Ikigai4Ever/RC_car_embedded_project/Documentation/ECE_4140_Project_Report.docx

Seek and Destroy RC Car

ECE–4140 Embedded Systems Project

Christopher Bowman (Masters)

Ty Ahrens

Blake Hudson (Masters)

Project Objective

Create an RC car that can autonomously find a package and be

manual controlled.

Overview

The Seek and Destroy RC car is a wireless RC car designed for Autonomous navigation and manual control. The RC car is composed of 3 different subsystems: Controller, Seeker, and Package. The Controller system controls the Seeker system which seeks the Package system. The Controller uses Multiple ADCs to control the movement of the Seeker module. Bluetooth modules using UART allow the Controller to send the ADC values wirelessly to the Seeker module. The Seeker module is equipped with 2 high RPM motors controlled with a PID using the motors encoder sensor for a closed loop feedback path. PID is fine-tuned which outputs corresponding PWM signals for the motors. The Seeker has custom 3d printed body and wheels. A Buck Converter is used to handle the 12V power supply for Motors and the Nucleo board. The Package module uses esp-32 signal strength to determine how far the Seeker is away from the Package. An Ultrasonic sensor is used to avoid obstacles while navigating towards the Package.

Detailed Design

Controller (Ty and Blake)

Seeker (Evan, Ty, and Blake)

Package (Blake)
