Ikigai4Ever/RC_car_embedded_project/Documentation/PCB_Pictures/BottomUp.png

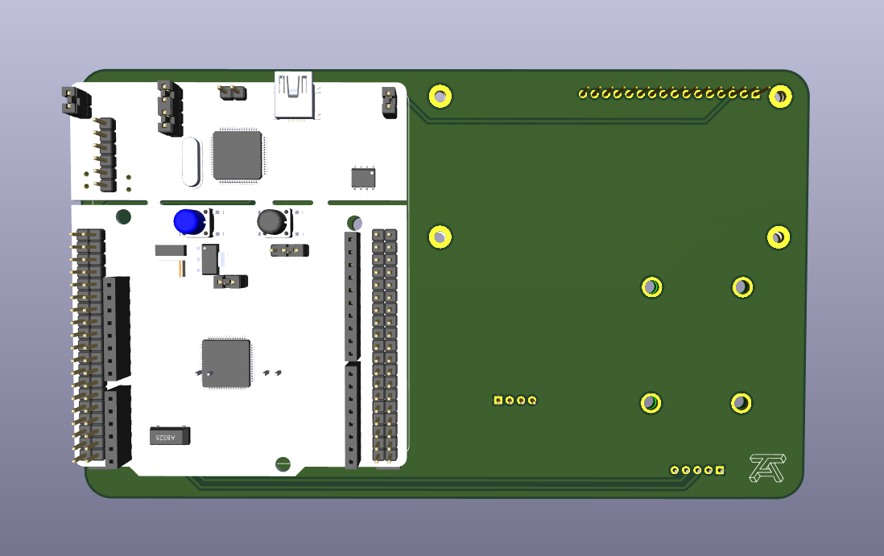
Documentation/PCB_Pictures/BottomUp.png
