Ikigai4Ever/RC_car_embedded_project/Documentation/PCB_Pictures/ISO_Bottom.png

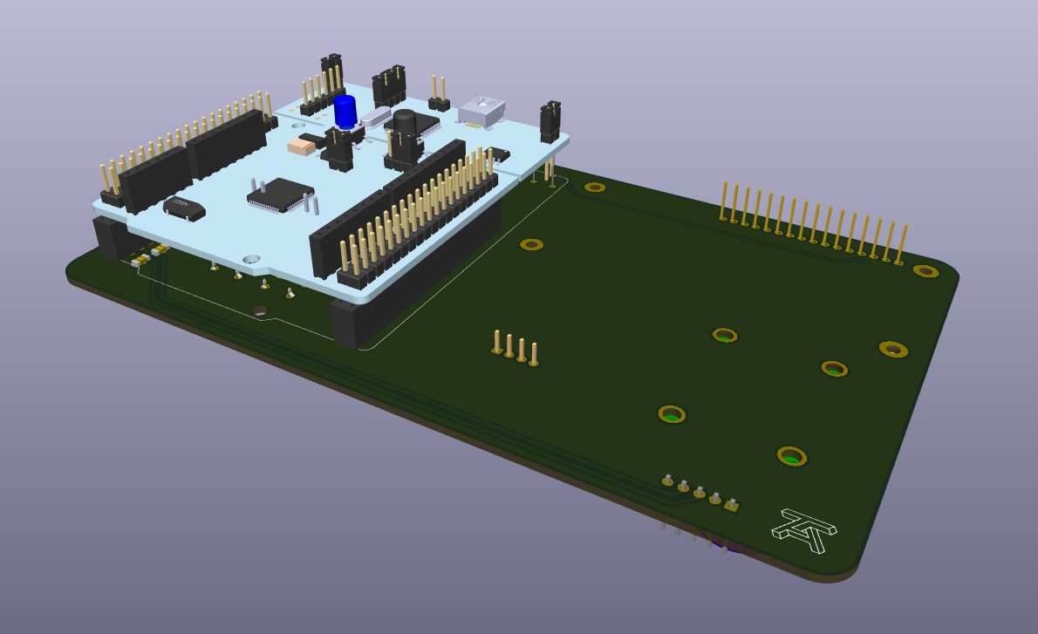
Documentation/PCB_Pictures/ISO_Bottom.png
