Ikigai4Ever/RC_car_embedded_project/Documentation/PCB_Pictures/ISO_Top.png

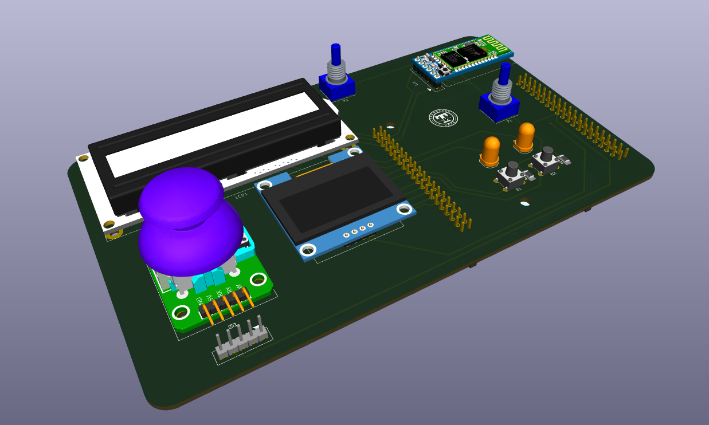
Documentation/PCB_Pictures/ISO_Top.png
