Ikigai4Ever/RC_car_embedded_project/Documentation/PCB_Pictures/PCB_Layout.png

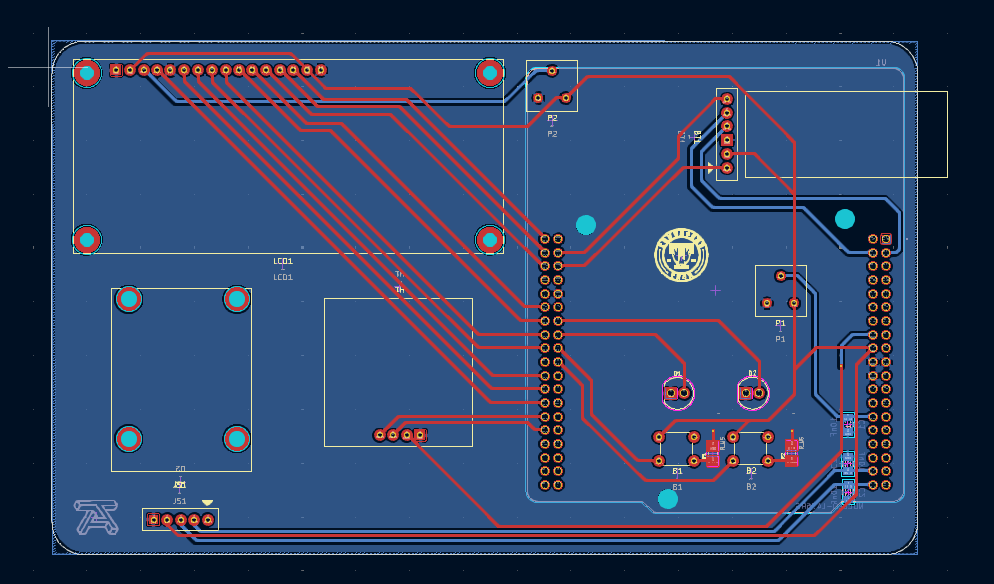
Documentation/PCB_Pictures/PCB_Layout.png
