Ikigai4Ever/RC_car_embedded_project/Documentation/PCB_Pictures/TopDown.png

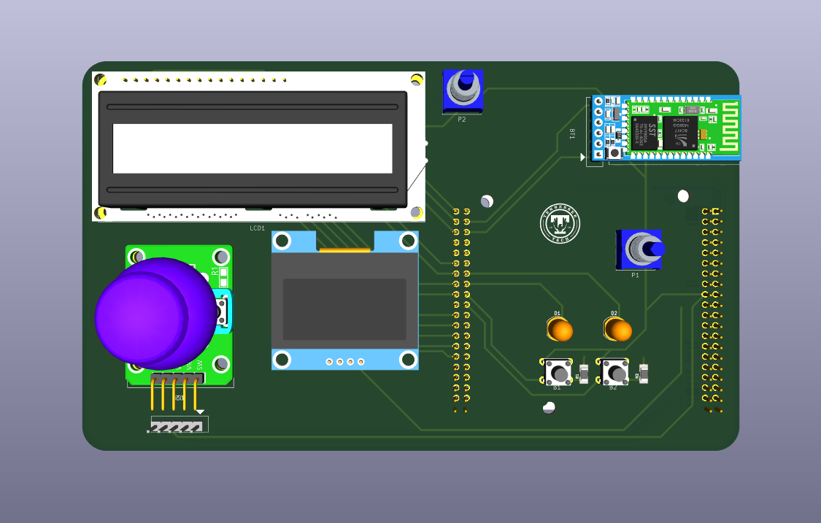
Documentation/PCB_Pictures/TopDown.png
