Ikigai4Ever/RC_car_embedded_project/Documentation/5140_BOM.xlsx

SEEKER Module
Price | Item | Website
$31.99 | LiPo Charger | https://www.amazon.com/gp/product/B08C592PNV/ref=ox_sc_act_image_9?smid=A2KWJCPIVXD7ZY&th=1
$42.98 | Lipo Battery and Bag | https://www.amazon.com/gp/product/B0CTCJSY2H/ref=ox_sc_act_title_8?smid=A646DVGSXYMNH&psc=1
$6.99 | Thermal pad | https://www.amazon.com/gp/product/B07TP3FXZK/ref=ox_sc_act_title_7?smid=A35AFW9EVJYR0N&th=1
$9.99 | Heatsink | https://www.amazon.com/gp/product/B07SMX1DB7/ref=ox_sc_act_title_6?smid=A3NG8YG8JA3ZUJ&psc=1
$5.99 | Fans | https://www.amazon.com/gp/product/B07G97L9TL/ref=ox_sc_act_image_5?smid=A3CX4TQNUXMB0L&th=1
$14.19 | H-Brdge Driver | https://www.amazon.com/gp/product/B0D732VYGZ/ref=ox_sc_act_image_4?smid=A3AG45GXH6FGYX&psc=1
$68.00 | 2 DC motrs | https://www.amazon.com/gp/product/B08ZK66BWC/ref=ox_sc_act_image_3?smid=A31G33MT63S07E&th=1
$9.99 | 12 AWG pigtails | https://www.amazon.com/gp/product/B0BLLL4FFS/ref=ox_sc_act_title_1?smid=A3M3XLEB8UBM5Y&psc=1
$190.12
