Ikigai4Ever/RC_car_embedded_project/KiCad/project/PCB_3D_MODELS/Buttons_and_Switches/TS02-66-70-BK-100-LCR-D.STEP

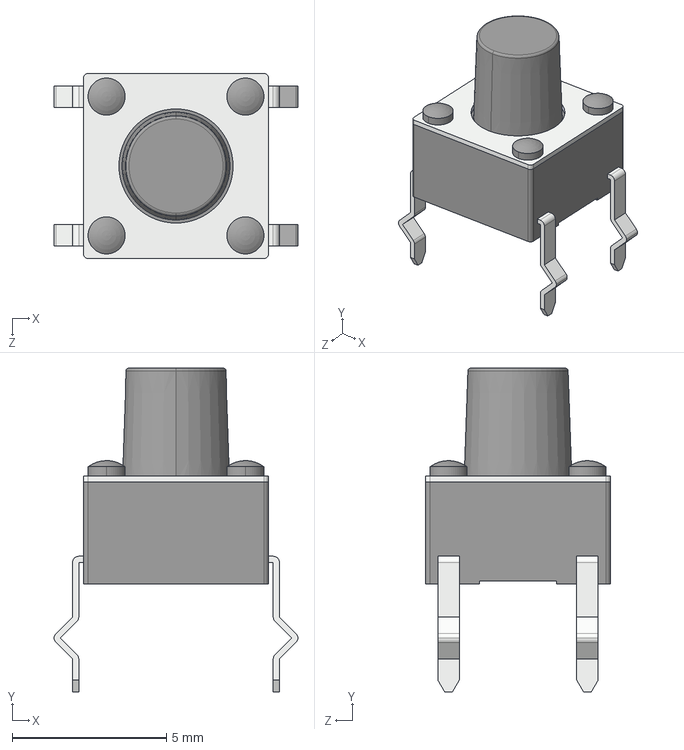
[picture p7: CAD file, 2025-11-24]
KiCad/project/PCB_3D_MODELS/Buttons_and_Switches/TS02-66-70-BK-100-LCR-D.STEP
7.90 x 10.5 x 6.00 mm
