Ikigai4Ever/RC_car_embedded_project/KiCad/project/PCB_3D_MODELS/Capacitors/SMD/C1206C103K4REC7210.step

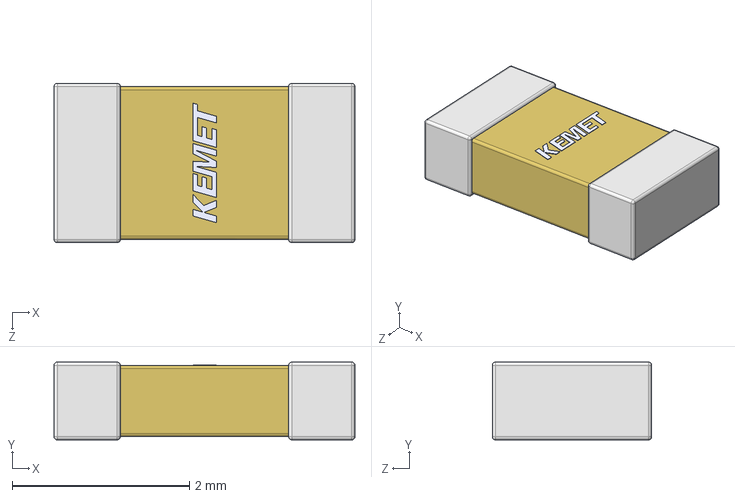
[picture p8: CAD file, 2025-11-24]
KiCad/project/PCB_3D_MODELS/Capacitors/SMD/C1206C103K4REC7210.step
3.40 x 0.88 x 1.80 mm
