Ikigai4Ever/RC_car_embedded_project/KiCad/project/PCB_3D_MODELS/LEDs/THRU/L08R5000Q1.step

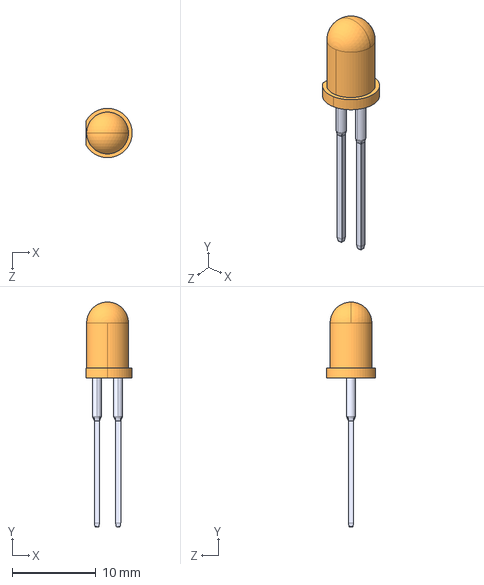
[picture p9: CAD file, 2025-11-24]
KiCad/project/PCB_3D_MODELS/LEDs/THRU/L08R5000Q1.step
5.55 x 26.9 x 5.90 mm
