Ikigai4Ever/RC_car_embedded_project/KiCad/project/PCB_3D_MODELS/Male_to_Female_Header_Pins/2x20 Stacking Header.step

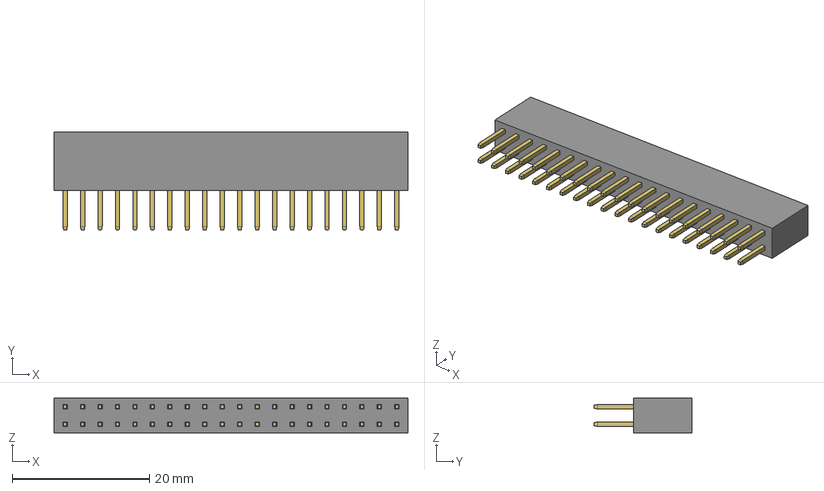
[picture p10: CAD file, 2025-11-24]
KiCad/project/PCB_3D_MODELS/Male_to_Female_Header_Pins/2x20 Stacking Header.step
51.5 x 14.3 x 5.08 mm
