Ikigai4Ever/RC_car_embedded_project/KiCad/project/PCB_3D_MODELS/Male_to_Male_Header_Pins/1x6.STEP

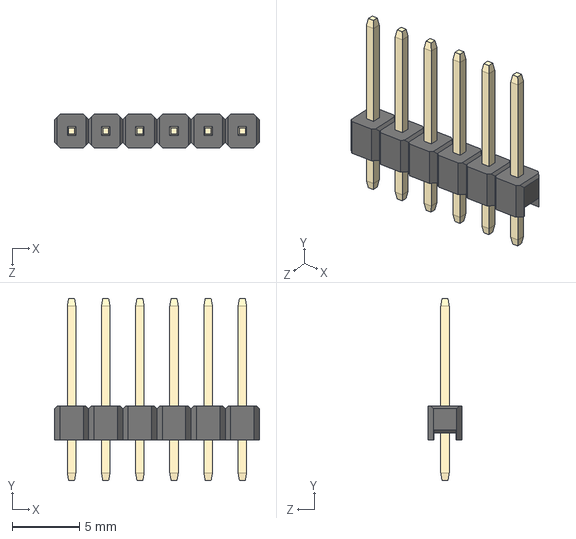
[picture p11: CAD file, 2025-11-24]
KiCad/project/PCB_3D_MODELS/Male_to_Male_Header_Pins/1x6.STEP
15.2 x 13.5 x 2.50 mm
