Ikigai4Ever/RC_car_embedded_project/KiCad/project/PCB_3D_MODELS/Potentiometers/3310Y-001-103L--3DModel-STEP-56544.STEP

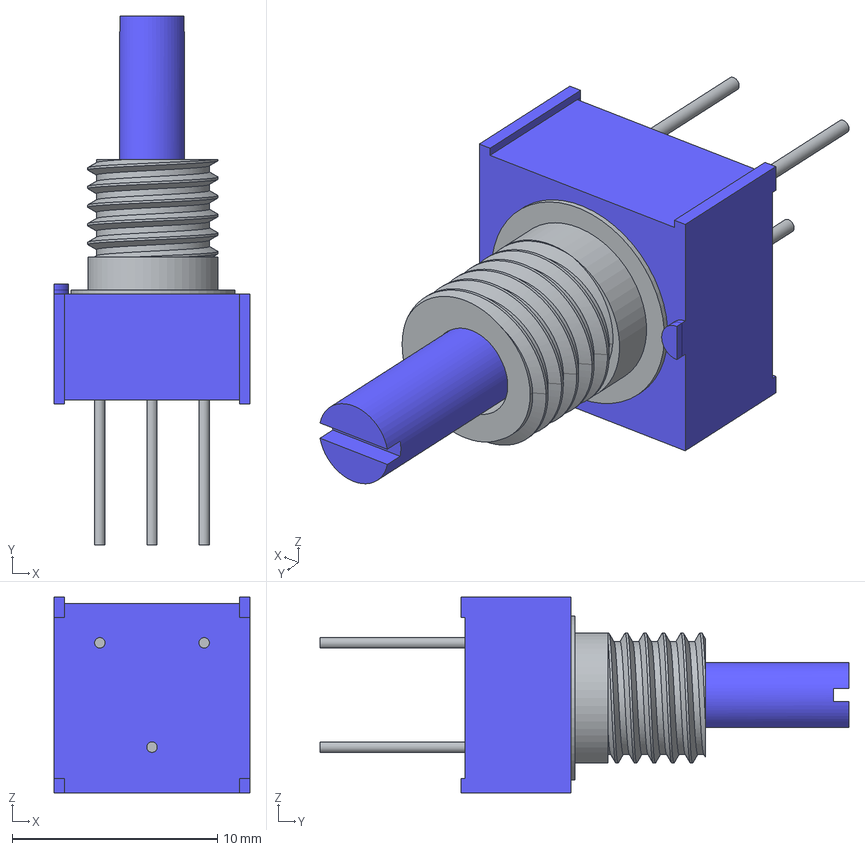
[picture p12: CAD file, 2025-11-24]
KiCad/project/PCB_3D_MODELS/Potentiometers/3310Y-001-103L--3DModel-STEP-56544.STEP
9.53 x 25.8 x 9.53 mm
