Ikigai4Ever/RC_car_embedded_project/KiCad/project/PCB_3D_MODELS/Resistors/SMD/RC1206JR-1010KL.step

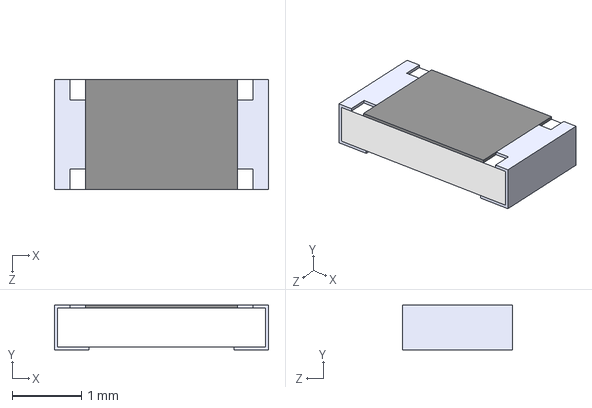
[picture p13: CAD file, 2025-11-24]
KiCad/project/PCB_3D_MODELS/Resistors/SMD/RC1206JR-1010KL.step
3.10 x 0.65 x 1.60 mm
