Ikigai4Ever/RC_car_embedded_project/KiCad/project/PCB_3D_MODELS/Visual_Devices/AZ-Delivery - OLED13 IIC.stp

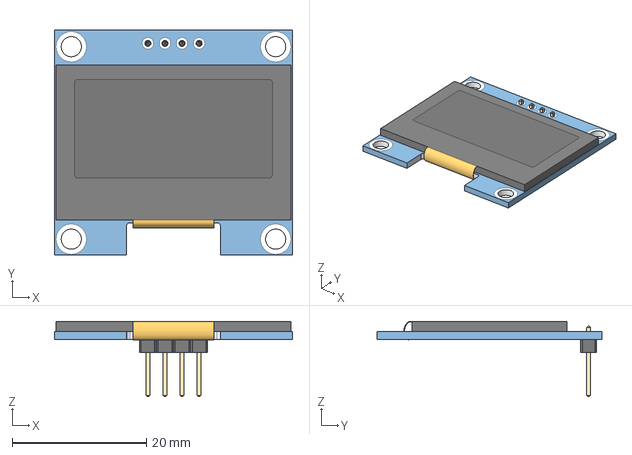
[picture p14: CAD file, 2025-11-24]
KiCad/project/PCB_3D_MODELS/Visual_Devices/AZ-Delivery - OLED13 IIC.stp
35.4 x 33.5 x 11.2 mm
