Ikigai4Ever/RC_car_embedded_project/KiCad/project/PCB_3D_MODELS/Buttons_and_Switches/12mm x 12mm Tactile switch Button.step

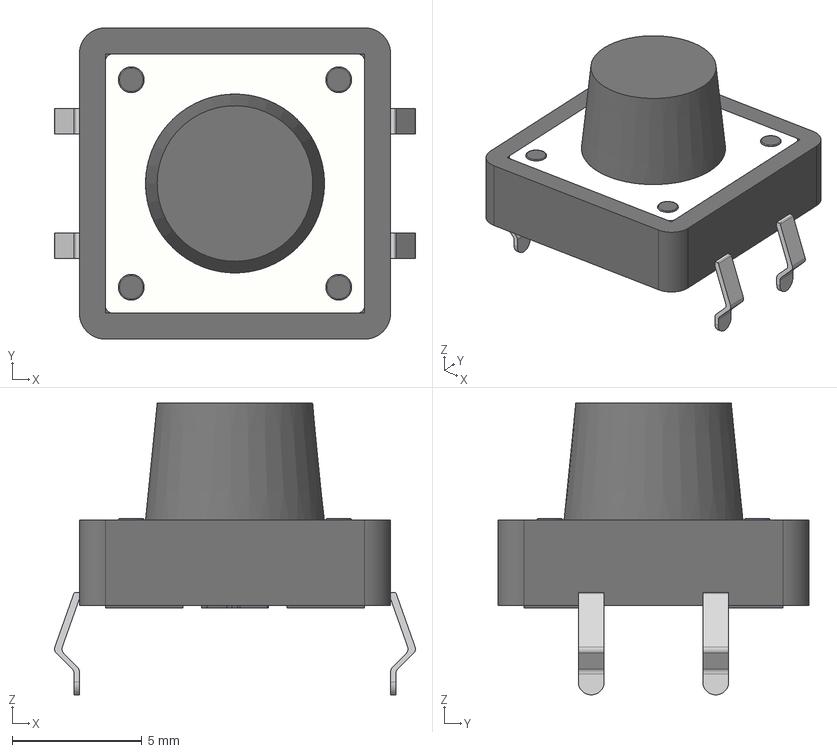
[picture p15: CAD file, 2025-11-24]
KiCad/project/PCB_3D_MODELS/Buttons_and_Switches/12mm x 12mm Tactile switch Button.step
13.9 x 12.0 x 11.2 mm
External Case
Steel Plate
Push Button
