Ikigai4Ever/RC_car_embedded_project/KiCad/project/PCB_3D_MODELS/Male_to_Male_Header_Pins/1x5.STEP

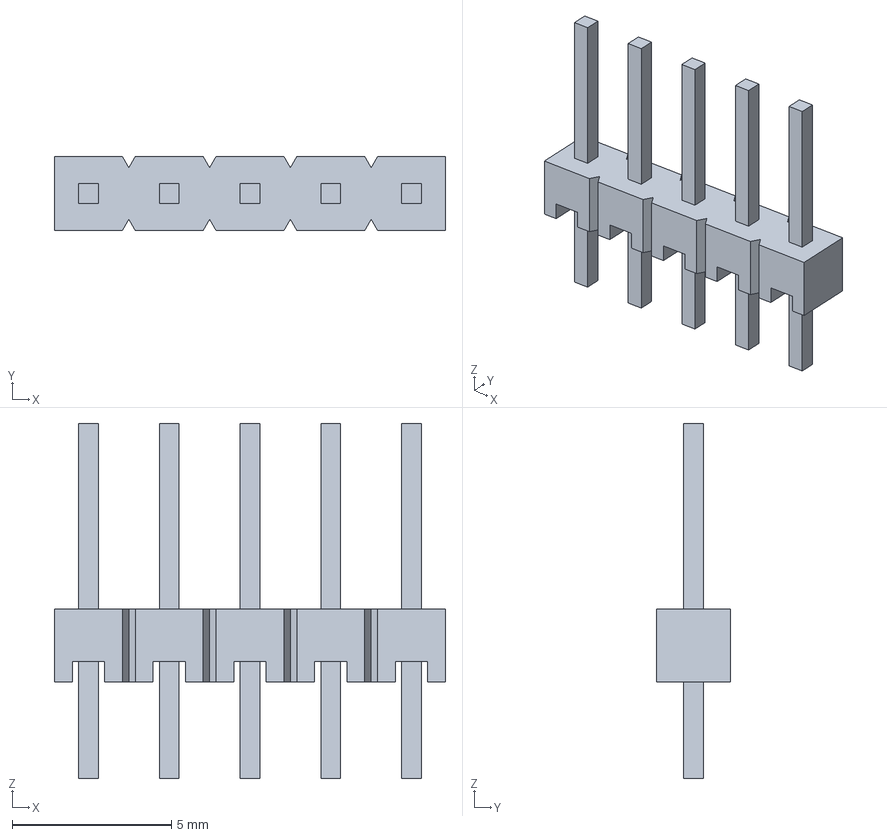
[picture p16: CAD file, 2025-11-24]
KiCad/project/PCB_3D_MODELS/Male_to_Male_Header_Pins/1x5.STEP
12.3 x 2.34 x 11.2 mm
