Ikigai4Ever/RC_car_embedded_project/KiCad/project/PCB_3D_MODELS/Male_to_Male_Header_Pins/1x4.STEP

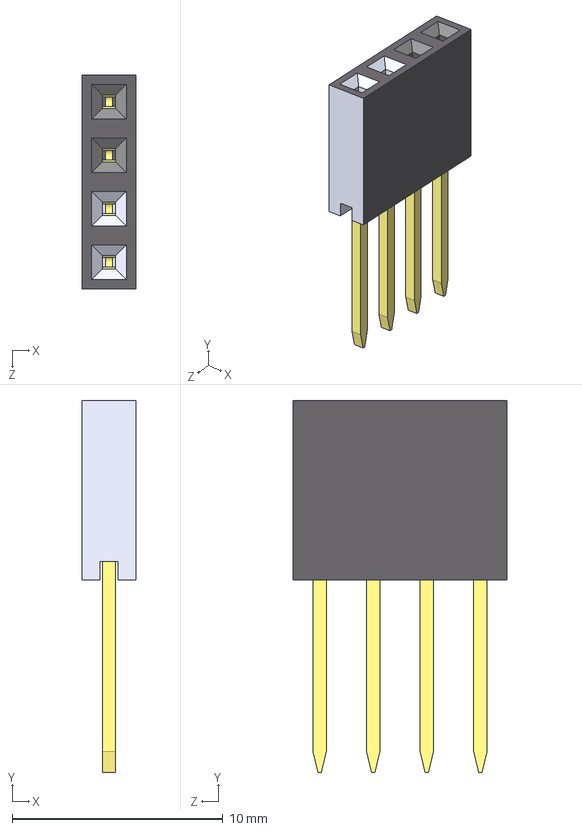
[picture p17: CAD file, 2025-11-24]
KiCad/project/PCB_3D_MODELS/Male_to_Male_Header_Pins/1x4.STEP
2.54 x 17.6 x 10.2 mm
