Ikigai4Ever/RC_car_embedded_project/KiCad/project/project.kicad_pcb

## KiCad design KiCad/project/project.kicad_pcb (2025-11-24)

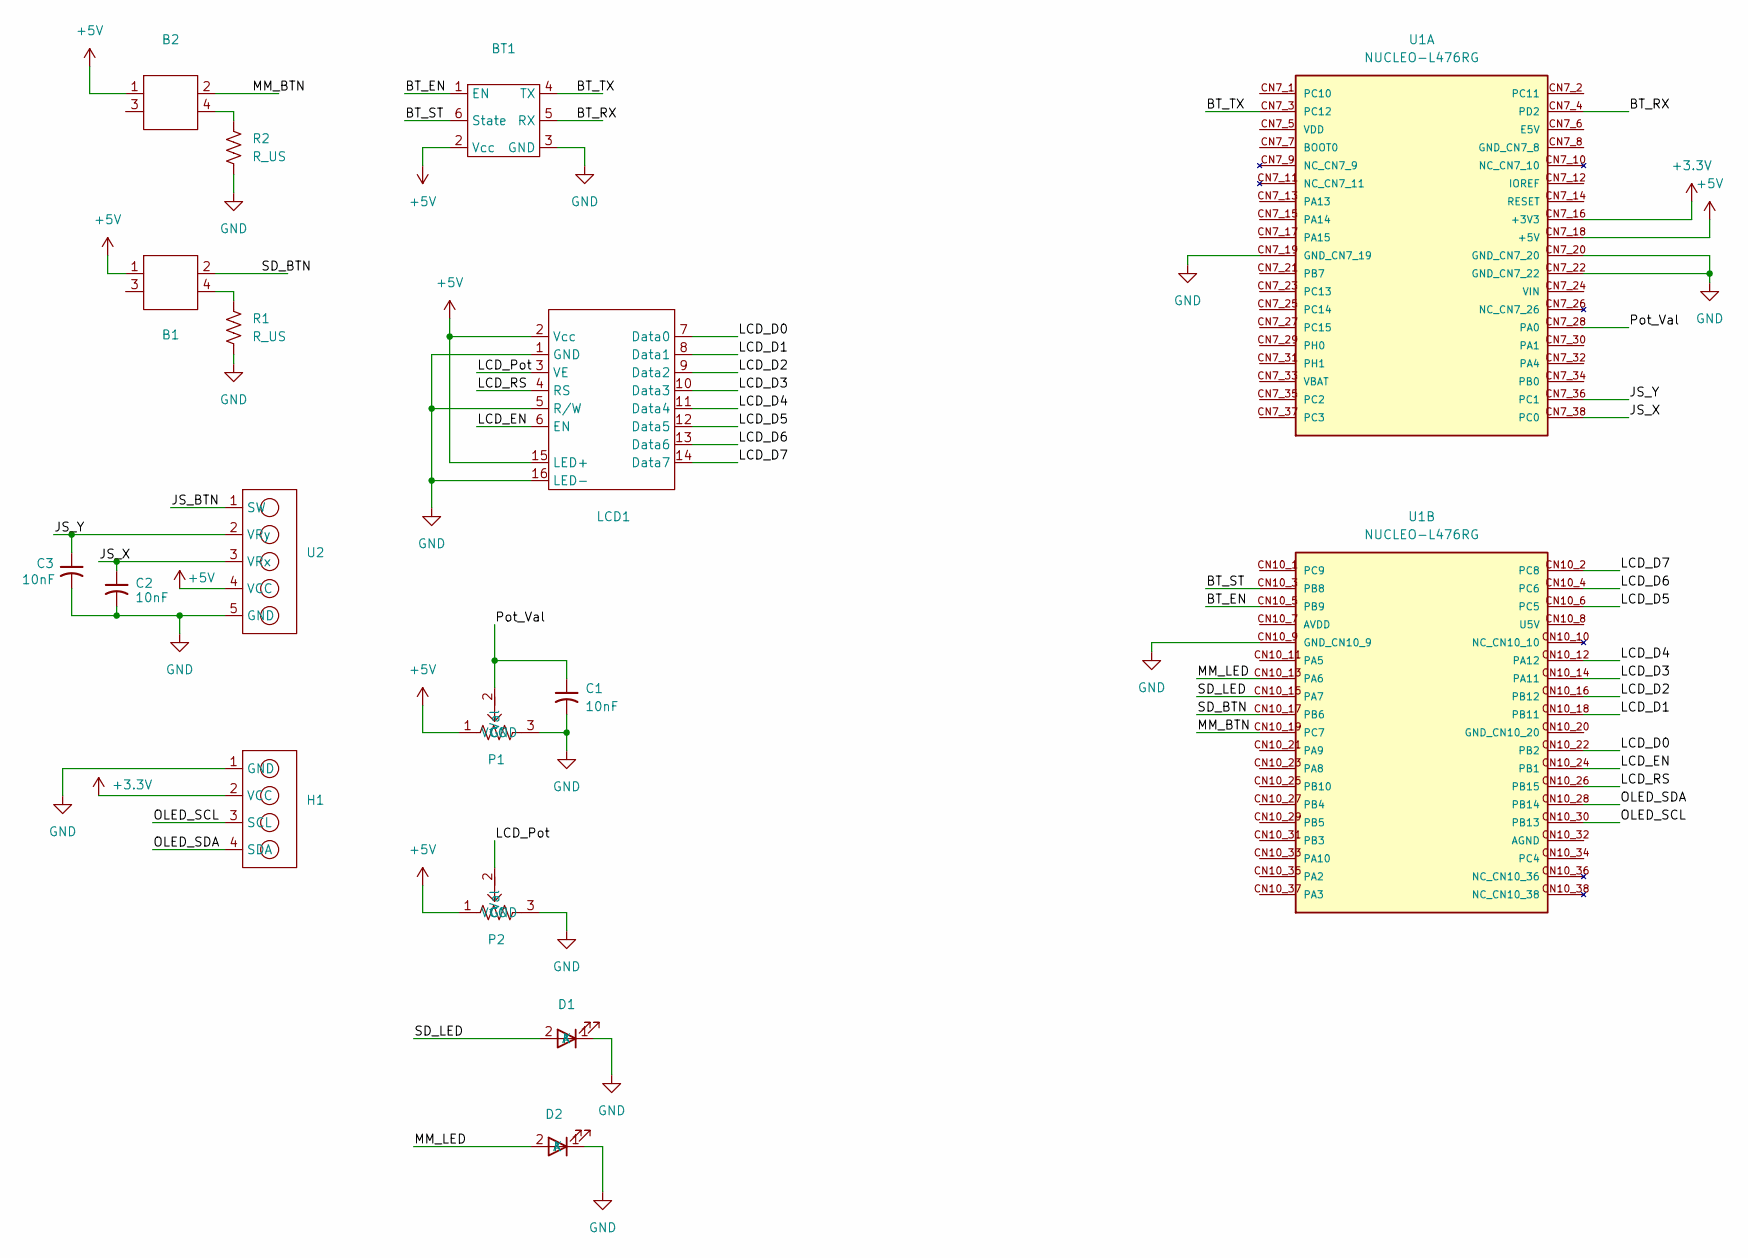
[picture p18: schematic project.kicad_sch]

Parts:
B1, B2: Button
BT1: HC-05
C1, C2, C3: 10nF; CAPC340180_88N_KEM
D1, D2: LED_THRU
H1: OLED
LCD1: LCD_Display
P1, P2: Potentiometer
R1, R2: R_US; RESC3216X65
U1: NUCLEO-L476RG; MODULE_NUCLEO-L476RG; PARTREV 15
U2: Joystick_Pins

Connections:
+3.3V: H1.2 (VCC), U1.CN7_16 (+3V3)
+5V: B1.1, B2.1, BT1.2 (Vcc), LCD1.2 (Vcc), LCD1.15 (LED+), P1.1 (VCC), P2.1 (VCC), U1.CN7_18 (+5V), U2.4 (VCC)
/BT_EN: BT1.1 (EN), U1.CN10_5 (PB9)
/BT_RX: BT1.5 (RX), U1.CN7_4 (PD2)
/BT_ST: BT1.6 (State), U1.CN10_3 (PB8)
/BT_TX: BT1.4 (TX), U1.CN7_3 (PC12)
/JS_BTN: U2.1 (SW)
/JS_X: C2.1, U1.CN7_38 (PC0), U2.3 (VRx)
/JS_Y: C3.1, U1.CN7_36 (PC1), U2.2 (VRy)
/LCD_D0: LCD1.7 (Data0), U1.CN10_22 (PB2)
/LCD_D1: LCD1.8 (Data1), U1.CN10_18 (PB11)
/LCD_D2: LCD1.9 (Data2), U1.CN10_16 (PB12)
/LCD_D3: LCD1.10 (Data3), U1.CN10_14 (PA11)
/LCD_D4: LCD1.11 (Data4), U1.CN10_12 (PA12)
/LCD_D5: LCD1.12 (Data5), U1.CN10_6 (PC5)
/LCD_D6: LCD1.13 (Data6), U1.CN10_4 (PC6)
/LCD_D7: LCD1.14 (Data7), U1.CN10_2 (PC8)
/LCD_EN: LCD1.6 (EN), U1.CN10_24 (PB1)
/LCD_Pot: LCD1.3 (VE), P2.2 (Val)
/LCD_RS: LCD1.4 (RS), U1.CN10_26 (PB15)
/MM_BTN: B2.2, U1.CN10_19 (PC7)
/MM_LED: D2.2 (A), U1.CN10_13 (PA6)
/OLED_SCL: H1.3 (SCL), U1.CN10_30 (PB13)
/OLED_SDA: H1.4 (SDA), U1.CN10_28 (PB14)
/Pot_Val: C1.1, P1.2 (Val), U1.CN7_28 (PA0)
/SD_BTN: B1.2, U1.CN10_17 (PB6)
/SD_LED: D1.2 (A), U1.CN10_15 (PA7)
GND: BT1.3 (GND), C1.2, C2.2, C3.2, D1.1 (K), D2.1 (K), H1.1 (GND), LCD1.1 (GND), LCD1.5 (R/W), LCD1.16 (LED-), P1.3 (GND), P2.3 (GND), R1.2, R2.2, U1.CN7_19 (GND_CN7_19), U1.CN7_20 (GND_CN7_20), U1.CN7_22 (GND_CN7_22), U1.CN10_9 (GND_CN10_9), U2.5 (GND)
unnamed: B1.4, R1.1
unnamed: B2.4, R2.1

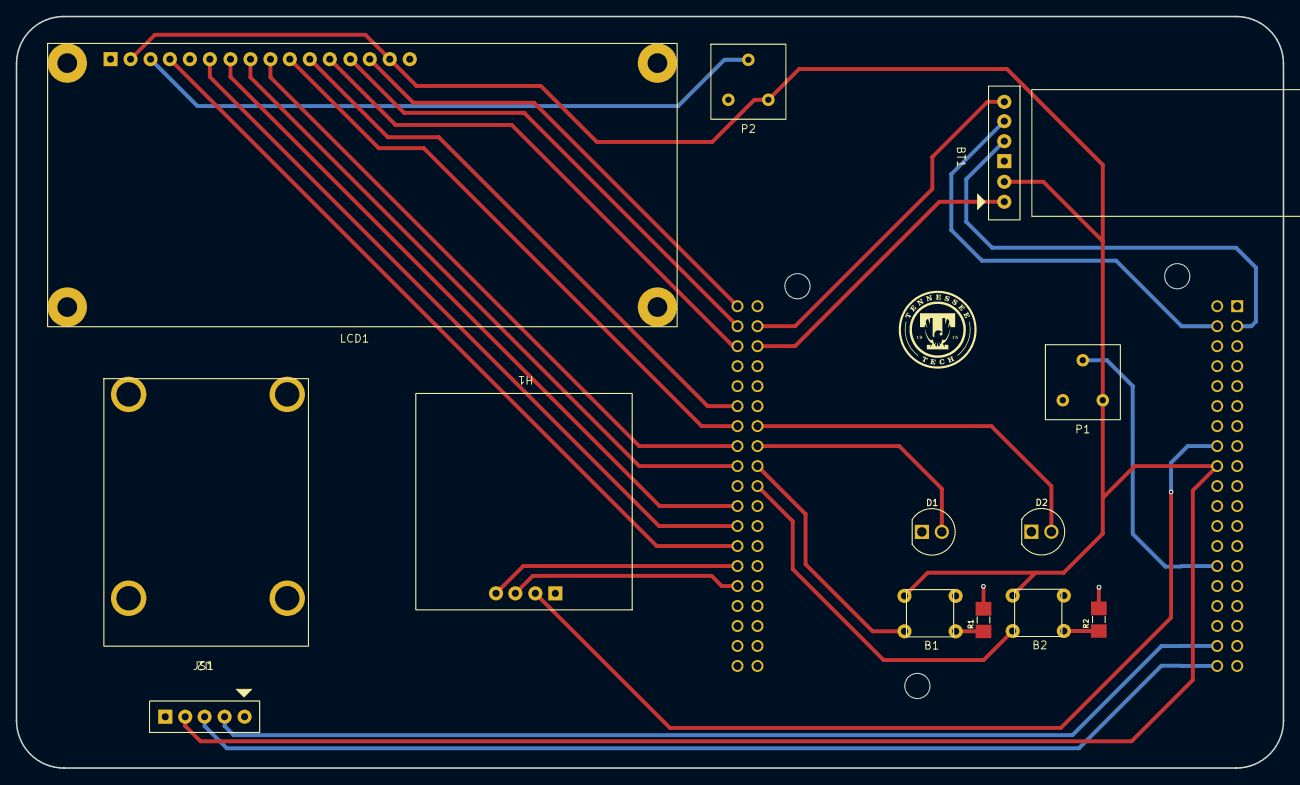
[picture p19: board project.kicad_pcb from above]

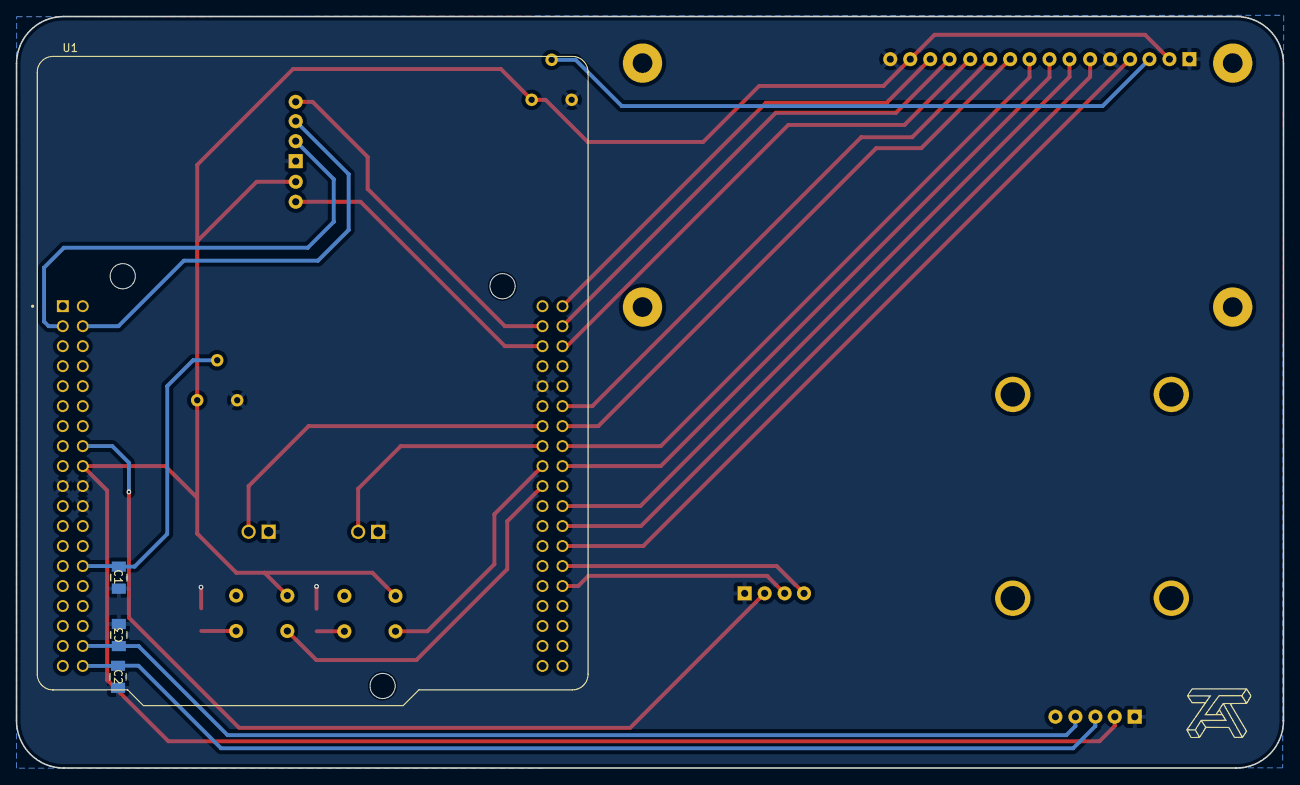
[picture p20: board project.kicad_pcb from below]

Board: 2 copper layers, 161.0 x 95.5 mm, 17 parts (4 on the bottom side), 29 nets.

Other parts of the board:
JS1: Joystick
