Ikigai4Ever/RC_car_embedded_project/STM32_Files/RC_Car_Seeker/main.c

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
/* Includes ------------------------------------------------------------------*/
#include "main.h"

/* USER CODE BEGIN Includes */
#include <math.h>
#include <string.h>
#include <stdio.h>
/* USER CODE END Includes */

TIM_HandleTypeDef htim1;
TIM_HandleTypeDef htim2;
TIM_HandleTypeDef htim3;
TIM_HandleTypeDef htim4;
TIM_HandleTypeDef htim6;

UART_HandleTypeDef huart5;

/* USER CODE BEGIN PV */
#define ADC_MAX 4095
#define ADC_MID 2048
#define DEADZONE 500
#define TIM_ARR 3999

#define SPEED_RAMP_STEP 2.0f  // How fast target speed changes (encoder counts per 0.01s)

// PID Constants - tune these values
#define KP 6.5f     // Proportional gain
#define KI 3.0f     // Integral gain
#define KD 0.04f    // Derivative gain

// ENCODER FILTER: Low-pass filter coefficient (0.0 to 1.0)
#define ENCODER_FILTER_ALPHA 0.3f  // 30% new reading, 70% old reading

// Encoder speed limits (counts per 0.01s = counts per 100Hz update)
#define ENCODER_MAX_SPEED 100
#define ENCODER_MIN_SPEED -100

// Bluetooth UART buffers
#define BT_RX_BUFFER_SIZE 64
uint8_t bt_rx_buffer[BT_RX_BUFFER_SIZE];
uint8_t bt_rx_index = 0;
volatile uint8_t bt_line_ready = 0;

// Received Bluetooth values (replacing local ADC)
volatile uint32_t bt_joy_x = ADC_MID;  // Default to center
volatile uint32_t bt_joy_y = ADC_MID;  // Default to center
volatile uint32_t bt_speed = 0;        // Default to stopped
volatile uint32_t last_bt_rx_time = 0; // Timeout safety

volatile int32_t joy_Y = 0;
volatile int32_t joy_X = 0;
volatile uint32_t speed = 0;
volatile uint32_t speed_base = 0;
volatile uint32_t raw_joy_Y = 0;
volatile uint32_t raw_joy_X = 0;

typedef struct
{
    volatile uint32_t ch1_pwm;
    volatile uint32_t ch2_pwm;
    volatile uint32_t target_ch1;
    volatile uint32_t target_ch2;

    // Encoder variables
    volatile int32_t encoder_count;
    volatile int32_t encoder_speed;
    volatile int32_t encoder_speed_raw;
    volatile float encoder_speed_filtered;
    volatile int32_t last_encoder_count;

    // PID variables
    volatile float target_speed;
    volatile float desired_speed;
    volatile float pid_error;
    volatile float pid_integral;
    volatile float pid_last_error;
    volatile float pid_output;

    // Diagnostic variables
    volatile float p_term;
    volatile float i_term;
    volatile float d_term;

} Motor;

Motor motor1;
Motor motor2;
/* USER CODE END PV */

void SystemClock_Config(void);
static void MX_GPIO_Init(void);
static void MX_TIM3_Init(void);
static void MX_TIM6_Init(void);
static void MX_TIM4_Init(void);
static void MX_TIM1_Init(void);
static void MX_TIM2_Init(void);
static void MX_UART5_Init(void);
/* USER CODE BEGIN 0 */
float ramp_speed_to_target(float current, float target)
{
    if (current < target)
    {
        current += SPEED_RAMP_STEP;
        if (current > target)
            current = target;
    }
    else if (current > target)
    {
        current -= SPEED_RAMP_STEP;
        if (current < target)
            current = target;
    }
    return current;
}

void update_encoder_speed(Motor *motor, int32_t current_encoder_count)
{
    motor->encoder_count = current_encoder_count;

    // Calculate the difference (could be large if counter wraps around)
    int32_t count_diff = current_encoder_count - motor->last_encoder_count;

    // Handle timer counter overflow/underflow (65535 wrap-around)
    if (count_diff > 32768)
    {
        count_diff -= 65536;
    }
    else if (count_diff < -32768)
    {
        count_diff += 65536;
    }

    // Negate if encoders are wired backwards
    motor->encoder_speed_raw = count_diff;

    // Apply low-pass filter to smooth out noise
    motor->encoder_speed_filtered = ENCODER_FILTER_ALPHA * (float)motor->encoder_speed_raw +
                                    (1.0f - ENCODER_FILTER_ALPHA) * motor->encoder_speed_filtered;

    motor->encoder_speed = (int32_t)motor->encoder_speed_filtered;
    motor->last_encoder_count = current_encoder_count;
}

// PID controller function
void update_pid(Motor *motor)
{
    if (motor->target_speed == 0.0f)
    {
        motor->pid_error = 0.0f;
        motor->pid_integral = 0.0f;
        motor->pid_last_error = 0.0f;
        motor->pid_output = 0.0f;
        motor->p_term = 0.0f;
        motor->i_term = 0.0f;
        motor->d_term = 0.0f;
        return;
    }

    float target_encoder_speed = fabs(motor->target_speed);
    float actual_encoder_speed = fabs((float)motor->encoder_speed);

    motor->pid_error = target_encoder_speed - actual_encoder_speed;

    motor->pid_integral += motor->pid_error * 0.01f;

    float max_integral = 200.0f;
    if (motor->pid_integral > max_integral)
        motor->pid_integral = max_integral;
    else if (motor->pid_integral < -max_integral)
        motor->pid_integral = -max_integral;

    float derivative = (motor->pid_error - motor->pid_last_error) / 0.01f;

    motor->p_term = KP * motor->pid_error;
    motor->i_term = KI * motor->pid_integral;
    motor->d_term = KD * derivative;

    float pid_speed_output = motor->p_term + motor->i_term + motor->d_term;

    motor->pid_output = (pid_speed_output / (float)ENCODER_MAX_SPEED) * (float)TIM_ARR;

    if (motor->pid_output > (float)TIM_ARR)
        motor->pid_output = (float)TIM_ARR;
    else if (motor->pid_output < 0.0f)
        motor->pid_output = 0.0f;

    motor->pid_last_error = motor->pid_error;
}

// Parse Bluetooth data and update motor control
void ParseBluetoothData(char *line)
{
    uint32_t x, y, pot;
    if (sscanf(line, "%lu,%lu,%lu", &x, &y, &pot) == 3)
    {
        // Update received values
        bt_joy_x = x;
        bt_joy_y = y;
        bt_speed = pot;

        // Process just like ADC callback
        raw_joy_X = bt_joy_x;
        raw_joy_Y = bt_joy_y;
        speed = bt_speed;

        // Calculate base speed from pot
        speed_base = (speed * TIM_ARR) / ADC_MAX;
        float speed_ratio = (float)speed_base / (float)TIM_ARR;

        joy_Y = (int32_t)ADC_MID - raw_joy_Y ;
        joy_X = raw_joy_X - (int32_t)ADC_MID;

        if (speed_base == 0 || (joy_Y > -(int32_t)DEADZONE && joy_Y < (int32_t)DEADZONE))
        {
            motor1.desired_speed = 0.0f;
            motor2.desired_speed = 0.0f;
        }
        else if (joy_Y > (int32_t)DEADZONE)

        {



        	if ((joy_X > -(int32_t)DEADZONE && joy_X < (int32_t)DEADZONE)) //no turning
        	{

        		motor1.desired_speed = speed_ratio * (float)ENCODER_MAX_SPEED;
        		motor2.desired_speed = speed_ratio * (float)ENCODER_MIN_SPEED;

        	}

        	else if (joy_X > (int32_t)DEADZONE) //turning right
        	{
        		motor1.desired_speed = speed_ratio * (float)ENCODER_MIN_SPEED;
        		motor2.desired_speed = speed_ratio * (float)ENCODER_MIN_SPEED;

        	}

        	else if (joy_X < -(int32_t)DEADZONE) //turning left
        	{
        	   motor1.desired_speed = speed_ratio * (float)ENCODER_MAX_SPEED;
        	   motor2.desired_speed = speed_ratio * (float)ENCODER_MAX_SPEED;

        	}



        }
        else if (joy_Y < -(int32_t)DEADZONE) //would backwards turning be the same as forwards turning?
        {


        	if ((joy_X > -(int32_t)DEADZONE && joy_X < (int32_t)DEADZONE)) //no turning
        	{

        		motor1.desired_speed = speed_ratio * (float)ENCODER_MIN_SPEED;
        		motor2.desired_speed = speed_ratio * (float)ENCODER_MAX_SPEED;

        	}

        	else if (joy_X > (int32_t)DEADZONE) //turning right
        	{
        		motor1.desired_speed = speed_ratio * (float)ENCODER_MIN_SPEED;
        		motor2.desired_speed = speed_ratio * (float)ENCODER_MIN_SPEED;

        	}

        	else if (joy_X < -(int32_t)DEADZONE) //turning left
        	{
        	   motor1.desired_speed = speed_ratio * (float)ENCODER_MAX_SPEED;
        	   motor2.desired_speed = speed_ratio * (float)ENCODER_MAX_SPEED;

        	}
        }
    }
}
/* USER CODE END 0 */

/**
  * @brief  The application entry point.
  * @retval int
  */
int main(void)
{

  /* MCU Configuration--------------------------------------------------------*/

  /* Reset of all peripherals, Initializes the Flash interface and the Systick. */
  HAL_Init();

  /* Configure the system clock */
  SystemClock_Config();

  /* Initialize all configured peripherals */
  MX_GPIO_Init();
  MX_TIM3_Init();
  MX_TIM6_Init();
  MX_TIM4_Init();
  MX_TIM1_Init();
  MX_TIM2_Init();
  MX_UART5_Init();
  /* USER CODE BEGIN 2 */
  // Initialize motor structs
  motor1.ch1_pwm = 0;
  motor1.ch2_pwm = 0;
  motor1.target_ch1 = 0;
  motor1.target_ch2 = 0;
  motor1.encoder_count = 0;
  motor1.encoder_speed = 0;
  motor1.encoder_speed_raw = 0;
  motor1.encoder_speed_filtered = 0.0f;
  motor1.last_encoder_count = 0;
  motor1.target_speed = 0.0f;
  motor1.desired_speed = 0.0f;
  motor1.pid_error = 0.0f;
  motor1.pid_integral = 0.0f;
  motor1.pid_last_error = 0.0f;
  motor1.pid_output = 0.0f;
  motor1.p_term = 0.0f;
  motor1.i_term = 0.0f;
  motor1.d_term = 0.0f;

  motor2.ch1_pwm = 0;
  motor2.ch2_pwm = 0;
  motor2.target_ch1 = 0;
  motor2.target_ch2 = 0;
  motor2.encoder_count = 0;
  motor2.encoder_speed = 0;
  motor2.encoder_speed_raw = 0;
  motor2.encoder_speed_filtered = 0.0f;
  motor2.last_encoder_count = 0;
  motor2.target_speed = 0.0f;
  motor2.desired_speed = 0.0f;
  motor2.pid_error = 0.0f;
  motor2.pid_integral = 0.0f;
  motor2.pid_last_error = 0.0f;
  motor2.pid_output = 0.0f;
  motor2.p_term = 0.0f;
  motor2.i_term = 0.0f;
  motor2.d_term = 0.0f;

  // Start encoder timers (TIM1 for motor1, TIM2 for motor2)
  HAL_TIM_Encoder_Start(&htim1, TIM_CHANNEL_ALL);
  HAL_TIM_Encoder_Start(&htim2, TIM_CHANNEL_ALL);

  HAL_TIM_Base_Start_IT(&htim6); //100Hz timer for speed calculation and control

  //start TIM3 (motor 1 PWM)
  if (HAL_TIM_Base_Start(&htim3) != HAL_OK)
  {
      while(1) { __NOP(); }
  }
  if (HAL_TIM_PWM_Start(&htim3, TIM_CHANNEL_1) != HAL_OK)
  {
      while(1) { __NOP(); }
  }
  if (HAL_TIM_PWM_Start(&htim3, TIM_CHANNEL_2) != HAL_OK)
  {
      while(1) { __NOP(); }
  }

  //start TIM4 (motor 2 PWM)
  if (HAL_TIM_Base_Start(&htim4) != HAL_OK)
  {
      while(1) { __NOP(); }
  }
  if (HAL_TIM_PWM_Start(&htim4, TIM_CHANNEL_1) != HAL_OK)
  {
      while(1) { __NOP(); }
  }
  if (HAL_TIM_PWM_Start(&htim4, TIM_CHANNEL_2) != HAL_OK)
  {
      while(1) { __NOP(); }
  }


  // ========== UART5 BLUETOOTH SETUP ==========
  // Enable UART5 interrupt in NVIC
  HAL_NVIC_SetPriority(UART5_IRQn, 0, 0);
  HAL_NVIC_EnableIRQ(UART5_IRQn);

  // ARM the UART to receive the first byte
  // This MUST be called to start the interrupt chain
  HAL_UART_Receive_IT(&huart5, &bt_rx_buffer[0], 1);

  // Initialize safety timeout
  last_bt_rx_time = HAL_GetTick();

  /* USER CODE END 2 */

  /* Infinite loop */
  /* USER CODE BEGIN WHILE */
  while (1)
  {
    /* USER CODE END WHILE */

    /* USER CODE BEGIN 3 */
  }
  /* USER CODE END 3 */
}

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
/* USER CODE BEGIN 4 */
void HAL_UART_RxCpltCallback(UART_HandleTypeDef *huart)
{
    if (huart->Instance == UART5)
    {
        // Update timeout
        last_bt_rx_time = HAL_GetTick();

        // Toggle LED to confirm we're receiving data
        HAL_GPIO_TogglePin(LD2_GPIO_Port, LD2_Pin);

        uint8_t received_byte = bt_rx_buffer[bt_rx_index];

        // Check for newline (end of packet)
        if (received_byte == '\n' || received_byte == '\r')
        {
            if (bt_rx_index > 0)  // Only process if we have data
            {
                bt_rx_buffer[bt_rx_index] = '\0';  // Null terminate
                ParseBluetoothData((char*)bt_rx_buffer);
                bt_rx_index = 0;  // Reset for next packet
            }
        }
        else if (bt_rx_index < BT_RX_BUFFER_SIZE - 1)
        {
            bt_rx_index++;
        }
        else
        {
            // Buffer overflow protection
            bt_rx_index = 0;
        }

        // CRITICAL: Re-enable interrupt for next byte
        HAL_UART_Receive_IT(&huart5, &bt_rx_buffer[bt_rx_index], 1);
    }
}

// Timer callback - 100Hz motor control loop
void HAL_TIM_PeriodElapsedCallback(TIM_HandleTypeDef *htim)
{
    if (htim->Instance == TIM6) // 100Hz update
    {
        // SAFETY: If no Bluetooth data for 500ms, stop motors
        if ((HAL_GetTick() - last_bt_rx_time) > 500)
        {
            motor1.desired_speed = 0.0f;
            motor2.desired_speed = 0.0f;
        }

        // Read encoder counts
        int32_t enc1_count = (int32_t)__HAL_TIM_GET_COUNTER(&htim1);
        int32_t enc2_count = (int32_t)__HAL_TIM_GET_COUNTER(&htim2);

        // Update encoder speeds
        update_encoder_speed(&motor1, enc1_count);
        update_encoder_speed(&motor2, enc2_count);



        // Ramp target_speed smoothly towards desired_speed
        motor1.target_speed = ramp_speed_to_target(motor1.target_speed, motor1.desired_speed);
        motor2.target_speed = ramp_speed_to_target(motor2.target_speed, motor2.desired_speed);

        // Update PID controllers
        update_pid(&motor1);
        update_pid(&motor2);

        // Set targets based on PID output - Motor 1
        if (motor1.target_speed > 0.0f)
        {
            motor1.target_ch1 = (uint32_t)motor1.pid_output;
            motor1.target_ch2 = 0;
        }
        else if (motor1.target_speed < 0.0f)
        {
            motor1.target_ch1 = 0;
            motor1.target_ch2 = (uint32_t)motor1.pid_output;
        }
        else
        {
            motor1.target_ch1 = 0;
            motor1.target_ch2 = 0;
        }

        // Set targets based on PID output - Motor 2
        if (motor2.target_speed > 0.0f)
        {
            motor2.target_ch1 = (uint32_t)motor2.pid_output;
            motor2.target_ch2 = 0;
        }
        else if (motor2.target_speed < 0.0f)
        {
            motor2.target_ch1 = 0;
            motor2.target_ch2 = (uint32_t)motor2.pid_output;
        }
        else
        {
            motor2.target_ch1 = 0;
            motor2.target_ch2 = 0;
        }

        // SAFETY: Block opposite direction until current direction stops
        if (motor1.ch1_pwm > 10 && motor1.target_ch2 > 0)
        {
            motor1.target_ch2 = 0;
        }
        if (motor1.ch2_pwm > 10 && motor1.target_ch1 > 0)
        {
            motor1.target_ch1 = 0;
        }

        if (motor2.ch1_pwm > 10 && motor2.target_ch2 > 0)
        {
            motor2.target_ch2 = 0;
        }
        if (motor2.ch2_pwm > 10 && motor2.target_ch1 > 0)
        {
            motor2.target_ch1 = 0;
        }

        // PID directly controls PWM
        motor1.ch1_pwm = motor1.target_ch1;
        motor1.ch2_pwm = motor1.target_ch2;
        motor2.ch1_pwm = motor2.target_ch1;
        motor2.ch2_pwm = motor2.target_ch2;

        // Write to PWM registers
        __HAL_TIM_SET_COMPARE(&htim3, TIM_CHANNEL_1, motor1.ch1_pwm);
        __HAL_TIM_SET_COMPARE(&htim3, TIM_CHANNEL_2, motor1.ch2_pwm);
        __HAL_TIM_SET_COMPARE(&htim4, TIM_CHANNEL_1, motor2.ch1_pwm);
        __HAL_TIM_SET_COMPARE(&htim4, TIM_CHANNEL_2, motor2.ch2_pwm);
    }
}



/* USER CODE END 4 */
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
