Ikigai4Ever/RC_car_embedded_project/Controller_Testing/Controller/Core/Inc/main.h

#define Manual_Mode_LED_Pin GPIO_PIN_6
#define Manual_Mode_LED_GPIO_Port GPIOA
#define SD_Mode_LED_Pin GPIO_PIN_7
#define SD_Mode_LED_GPIO_Port GPIOA
#define LCD_D5_Pin GPIO_PIN_5
#define LCD_D5_GPIO_Port GPIOC
#define LCD_EN_Pin GPIO_PIN_1
#define LCD_EN_GPIO_Port GPIOB
#define LCD_D0_Pin GPIO_PIN_2
#define LCD_D0_GPIO_Port GPIOB
#define LCD_D1_Pin GPIO_PIN_11
#define LCD_D1_GPIO_Port GPIOB
#define LCD_D2_Pin GPIO_PIN_12
#define LCD_D2_GPIO_Port GPIOB
#define OLED_SCL_Pin GPIO_PIN_13
#define OLED_SCL_GPIO_Port GPIOB
#define OLED_SDA_Pin GPIO_PIN_14
#define OLED_SDA_GPIO_Port GPIOB
#define LCD_RS_Pin GPIO_PIN_15
#define LCD_RS_GPIO_Port GPIOB
#define LCD_D6_Pin GPIO_PIN_6
#define LCD_D6_GPIO_Port GPIOC
#define Manual_Mode_Button_Pin GPIO_PIN_7
#define Manual_Mode_Button_GPIO_Port GPIOC
#define Manual_Mode_Button_EXTI_IRQn EXTI9_5_IRQn
#define LCD_D7_Pin GPIO_PIN_8
#define LCD_D7_GPIO_Port GPIOC
#define LCD_D3_Pin GPIO_PIN_11
#define LCD_D3_GPIO_Port GPIOA
#define LCD_D4_Pin GPIO_PIN_12
#define LCD_D4_GPIO_Port GPIOA
#define Bluetooth_TX_Pin GPIO_PIN_2
#define Bluetooth_TX_GPIO_Port GPIOD
#define SD_Button_Pin GPIO_PIN_6
#define SD_Button_GPIO_Port GPIOB
#define SD_Button_EXTI_IRQn EXTI9_5_IRQn
#define Bluetooth_State_Pin GPIO_PIN_8
#define Bluetooth_State_GPIO_Port GPIOB
#define Bluetooth_Enable_Pin GPIO_PIN_9
#define Bluetooth_Enable_GPIO_Port GPIOB
