Ikigai4Ever/RC_car_embedded_project/(commit log)

2025-10-20 Update README with PCB section and resources
    Added PCB portion with relevant links.
2025-10-20 Added in both libraries
    Added in both footprint libraries for the schematic and the pcb design
2025-10-20 Added project file
    Added in the project file as well to view on own device
    [project.kicad_pcb, project.kicad_sch]
2025-10-20 Updated project & create pinout map
    Updated the project file and added another footprint library that needs to be added. Also created a .ioc file for the controller STM32
    [project.kicad_pcb, project.kicad_sch]
2025-10-20 Added pin map for controller
    [RC_Car_Controller_Pinnout.csv]
2025-10-22 Added BOM for Project
    Added a good chunk of materials for the Seeker module, still need to think about servos, fuses, capacitors, and different wire AWGS
    [5140_BOM.xlsx]
2025-10-29 Updated PCB schematic and pinout for the ioc file because it was funky
    [RC_Car_Controller_Pinnout.csv, project.kicad_pcb, project.kicad_sch]
2025-10-29 Updated pinnout for controller
    [RC_Car_Controller_Pinnout.csv]
2025-10-31 Update stuff :)
    [project.kicad_pcb, project.kicad_sch]
2025-11-02 Updated schematic to get ready to send out
    [project.kicad_pcb]
2025-11-03 Updated .ioc file for the controller
    [RC_Car_Controller_Pinnout.csv]
2025-11-08 Updated PCB for parallel capacitors
    [project.kicad_pcb, project.kicad_sch]
2025-11-17 Created the test_motor folder
    This folder contains the code for the motor testing before wireless communication. Inside are the Main.c and IOC file.
2025-11-17 Added the Motor_Test ioc file
2025-11-21 Create README.md for Bluetooth STM32 project
    Added comprehensive README.md for Bluetooth STM32 project, detailing setup, features, and usage instructions.
2025-11-21 Revise README for Bluetooth UART STM32 Library
    Updated README to clarify Bluetooth library functionality and corrected baud rate information.
2025-11-22 Change baud rate in Bluetooth UART STM32 README
    Updated baud rate from 115200 to 9600 in README.
2025-11-22 Moving files to correct places
    [Controller.ioc, functions.c, functions.h, lcd_driver.c, lcd_driver.h, main.c, main.h]
2025-11-22 Wrong folder, should be STM32_Files
    [Seeker.ioc, main.c]
2025-11-24 Added in 3D models for pcb
    [12mm x 12mm Tactile switch Button.step, 1x4.STEP, 1x5.STEP, 1x6.STEP, 2x20 Stacking Header.step, 3310Y-001-103L--3DModel-STEP-56544.STEP, AZ-Delivery - OLED13 IIC.stp, L08R5000Q1.step]
2025-11-24 FInished up 3D model for the STM32 Board
    [C1206C103K4REC7210.step, project.kicad_pcb]
2025-11-24 Uploaded PCB Pictures w/ 3D models
