Ikigai4Ever/RC_car_embedded_project/(notices)

Notices in the files:
Controller_Testing/Controller/Core/Inc/main.h:
Copyright (c) 2025 STMicroelectronics.
All rights reserved.
This software is licensed under terms that can be found in the LICENSE file
